garrettsworkshop/GW28R8128/Documentation/IIgs ROM01/Removal.png

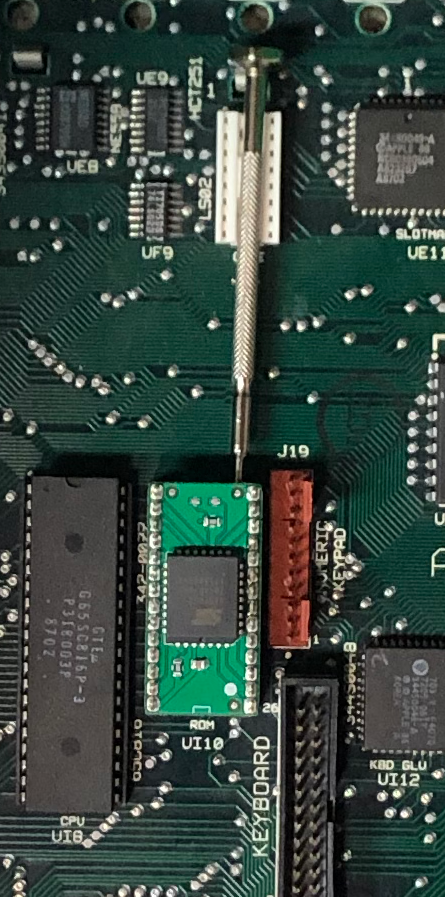
Documentation/IIgs ROM01/Removal.png
