garrettsworkshop/GW28R8128/Documentation/FrontIsom.png

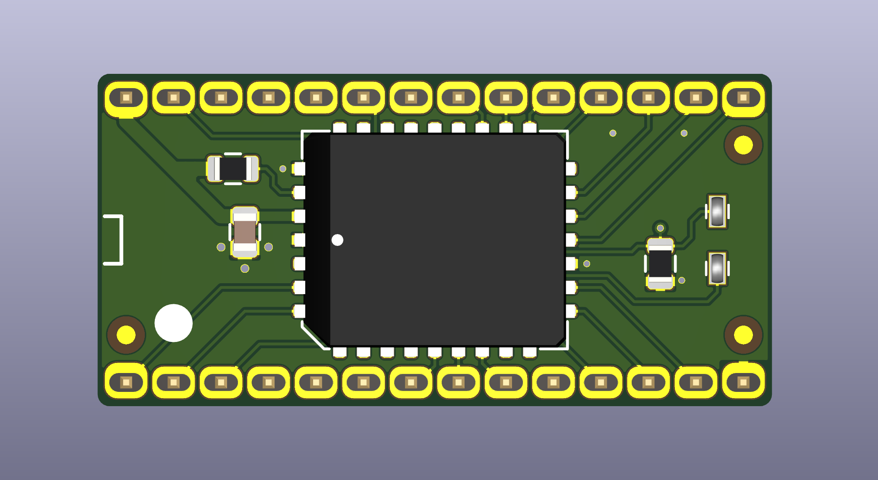
Documentation/FrontIsom.png
