garrettsworkshop/GW28R8128/Documentation/Perspective.png

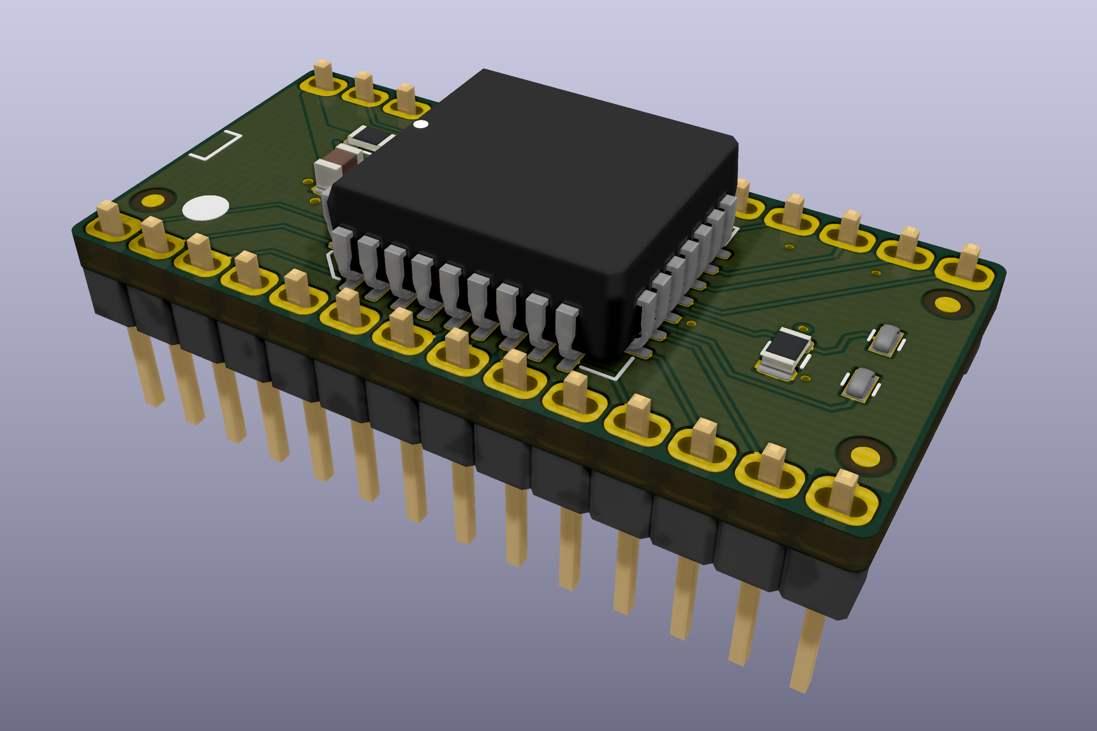
Documentation/Perspective.png
