garrettsworkshop/GW28R8128/Documentation/Schematic.pdf

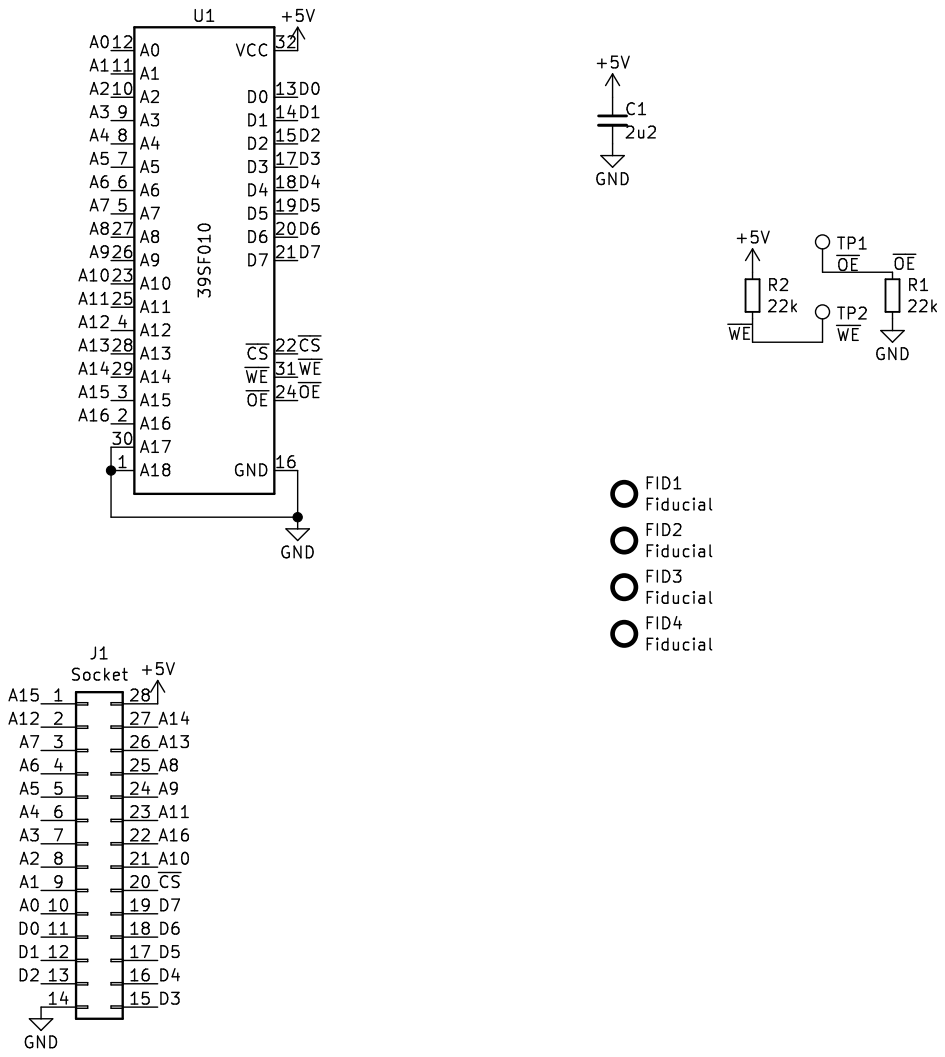
[picture p4: page 1]
