garrettsworkshop/GW28R8128/Documentation/Placement.pdf

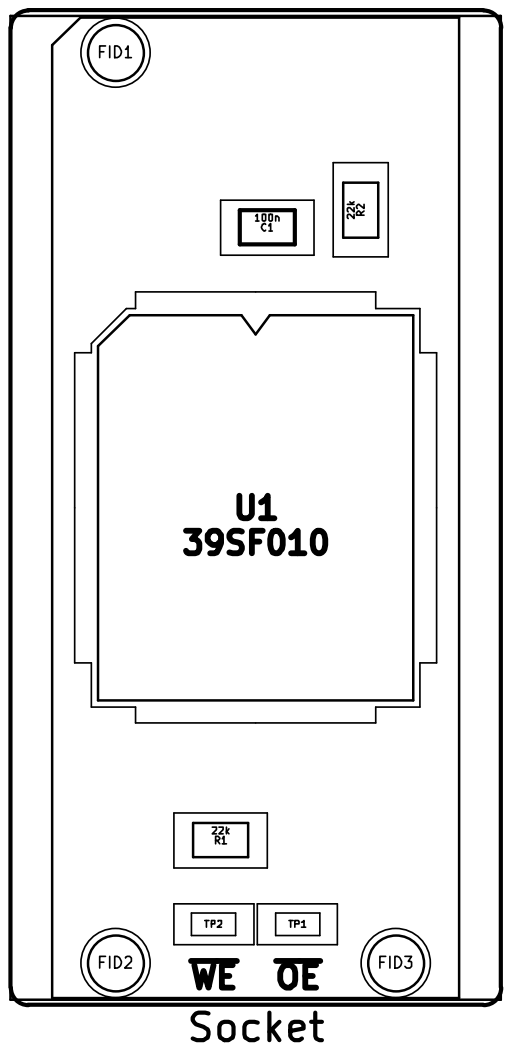
[picture p5: page 1]
