garrettsworkshop/GW28R8128/(commit log)

2019-06-26 Finished but no jumper for WE/OE
    [28SF8128.sch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]
2019-06-26 Changed name
    [28SF8148-B_SilkS.gbo, GW28R8128-B_Cu.gbl, GW28R8128-B_Mask.gbs, GW28R8128-B_SilkS.gbo, GW28R8128-Edge_Cuts.gm1, GW28R8128-F_Cu.gtl, GW28R8128-F_Mask.gts, GW28R8128-F_Paste.gtp]
2019-07-23 Added PDF schematic
    [GW28R8128.sch]
2019-12-21 Forked header, as submitted to JLCPCB
    [GW28R8128-B_Cu.gbl, GW28R8128-B_Mask.gbs, GW28R8128-B_SilkS.gbo, GW28R8128-Edge_Cuts.gm1, GW28R8128-F_Cu.gtl, GW28R8128-F_Mask.gts, GW28R8128-F_Paste.gtp, GW28R8128-F_SilkS.gto]
2020-05-20 Added ground via to R1
    [GW28R8128.kicad_pcb]
2020-05-20 Filled zones
    [GW28R8128.kicad_pcb]
2021-03-12 Small update
    [GW28R8128-B_Cu.gbl, GW28R8128-B_Mask.gbs, GW28R8128-B_SilkS.gbo, GW28R8128-Edge_Cuts.gm1, GW28R8128-F_Cu.gtl, GW28R8128-F_Mask.gts, GW28R8128-F_Paste.gtp, GW28R8128-F_SilkS.gto]
2021-04-03 Remove "J1" text on back of board
    [GW28R8128-B_Cu.gbl, GW28R8128-B_Mask.gbs, GW28R8128-B_SilkS.gbo, GW28R8128-Edge_Cuts.gm1, GW28R8128-F_Cu.gtl, GW28R8128-F_Mask.gts, GW28R8128-F_Paste.gtp, GW28R8128-F_SilkS.gto]
2021-04-03 Enlarged mask bridges
    [GW28R8128-B_Cu.gbl, GW28R8128-B_Mask.gbs, GW28R8128-B_SilkS.gbo, GW28R8128-Edge_Cuts.gm1, GW28R8128-F_Cu.gtl, GW28R8128-F_Mask.gts, GW28R8128-F_Paste.gtp, GW28R8128-F_SilkS.gto]
2021-04-03 Remove fiducials to look better
    [GW28R8128-B_Cu.gbl, GW28R8128-B_Mask.gbs, GW28R8128-B_SilkS.gbo, GW28R8128-Edge_Cuts.gm1, GW28R8128-F_Cu.gtl, GW28R8128-F_Mask.gts, GW28R8128-F_Paste.gtp, GW28R8128-F_SilkS.gto]
